lampmerchant/tashtalk/tashtalk2-rpihat/README.md

TashTalk 2 Hat
==============

## Bill of Materials

| Qty | Make | Model | Description | Buy Link |
| --- | ---  | --- | --- | --- |
| 1 | TI | SN65HVD12P | RS-422/485 transceiver | [DigiKey](https://www.digikey.com/en/products/detail/texas-instruments/SN65HVD12P/513465) |
| 1 | Microchip | PIC12F1840 | Microcontroller | [DigiKey](https://www.digikey.com/en/products/detail/microchip-technology/PIC12F1840-I-P/2651357) |
| 1 | Sullins | SFH11-PBPC-D20-ST-BK | 40-pin female header | [DigiKey](https://www.digikey.com/en/products/detail/sullins-connector-solutions/SFH11-PBPC-D20-ST-BK/1990093) |
| 1 | Panasonic | ECE-A1VKS100 | 10 uF radial capacitor | [DigiKey](https://www.digikey.com/en/products/detail/panasonic-electronic-components/ECE-A1VKS100/160560) |
| 1 | Stackpole | CFM14JT10K0 | 10k ohm resistor | [DigiKey](https://www.digikey.com/en/products/detail/stackpole-electronics-inc/CFM14JT10K0/1742061) |
| 1 | MaxCom | MMDF-8FOB-1 | 8-pin mini DIN connector | [Jameco](https://www.jameco.com/webapp/wcs/stores/servlet/ProductDisplay?productId=207722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) |
| 2 | TE Connectivity | 390261-2 | 8-pin DIP socket | [Jameco](https://www.jameco.com/webapp/wcs/stores/servlet/ProductDisplay?productId=526299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) |
