lampmerchant/tashtalk/(commit log)

2023-02-27 add TashTalk 2 Raspberry Pi hat
    [tashtalk2-rpihat.brd]
2023-03-12 specify prototype used v1.x firmware
2023-03-12 add BOM for TashTalk 2 hat
2024-04-04 add PCBs and Products section to README
2024-04-04 expand PCBs and Products section, include software
2026-05-08 docs: Add TashTalk USB + TailTalk to readme
    Adds a reference for the just released TashTalk USB adapter, accompanying TashTalk Rust driver and AppleTalk stack for it.
